cliffgraph/MSX-WiMuse/docs/MSX WiMuse partslist.xlsx

WiMuse partslist
No. | 部品名 | 数量 | 購入元 | 備考
1 | ユニバーサル基板 MPC-P60 (MCC-152 代替) | 1 | 電子部品通販 M.A.D. |  | https://la04528673.shop-pro.jp/
2 | ESP32-DevKitC(もしくはESP32-DevKitC-32E) | 1 | 秋月電子 | 通販コード M-11819 | https://akizukidenshi.com/catalog/g/gM-11819/
3 | Sipeed Tang Nano FPGAボード GW1N-1 FPGAチップ | 1 | Seeed |  | https://jp.seeedstudio.com/Sipeed-Tang-Nano-FPGA-board-powered-by-GW1N-1-FPGA-p-4304.html
4 | 74HC32AP | 1 | 秋月電子 | 通販コード I-12877 | https://akizukidenshi.com/catalog/g/gI-12877/
5 | SN74LVC245AN | 3 | マルツ電波 |  | https://www.marutsu.co.jp/pc/i/14242773/
6 | ICソケット 14ピン | 1 |  | 74HC32AP用
7 | ICソケット 20ピン | 3 |  | SN74LVC245AN用
8 | セラミックコンデンサ 104 | 4
9 | ブレッドボード用ＤＣジャック | 1 | 秋月電子 | 通販コード K-05148 | https://akizukidenshi.com/catalog/g/gK-05148/
10 | 電解コンデンサ 16V 47uF | 1 | 秋月電子 | 通販コード P-10270 | https://akizukidenshi.com/catalog/g/gP-10270/
11 | ピンへッダ２ピン 2.54mmピッチ | 2 | 秋月電子 | 通販コード C-08593 | https://akizukidenshi.com/catalog/g/gC-08593/
12 | ジャンパー用 2.54mmピッチ | 1
13 | ACアダプター センタープラス 5Vで1A以上のもの | 1
14 | 分割ロングピンソケット1x40 | 3 | 秋月電子 | ESP32,TangNano,有機EL用
15 | 0.96インチ有機ELディスプレイ | 1 | 秋月電子 | 通販コード P-12031 | https://akizukidenshi.com/catalog/g/gP-12031/
16 | 抵抗 10kΩ | 2
 | ※16,17は実装しなくても実用上問題なし。
