cliffgraph/MSX-WiMuse/docs/MSX WiMuse schematic.pdf.pdf

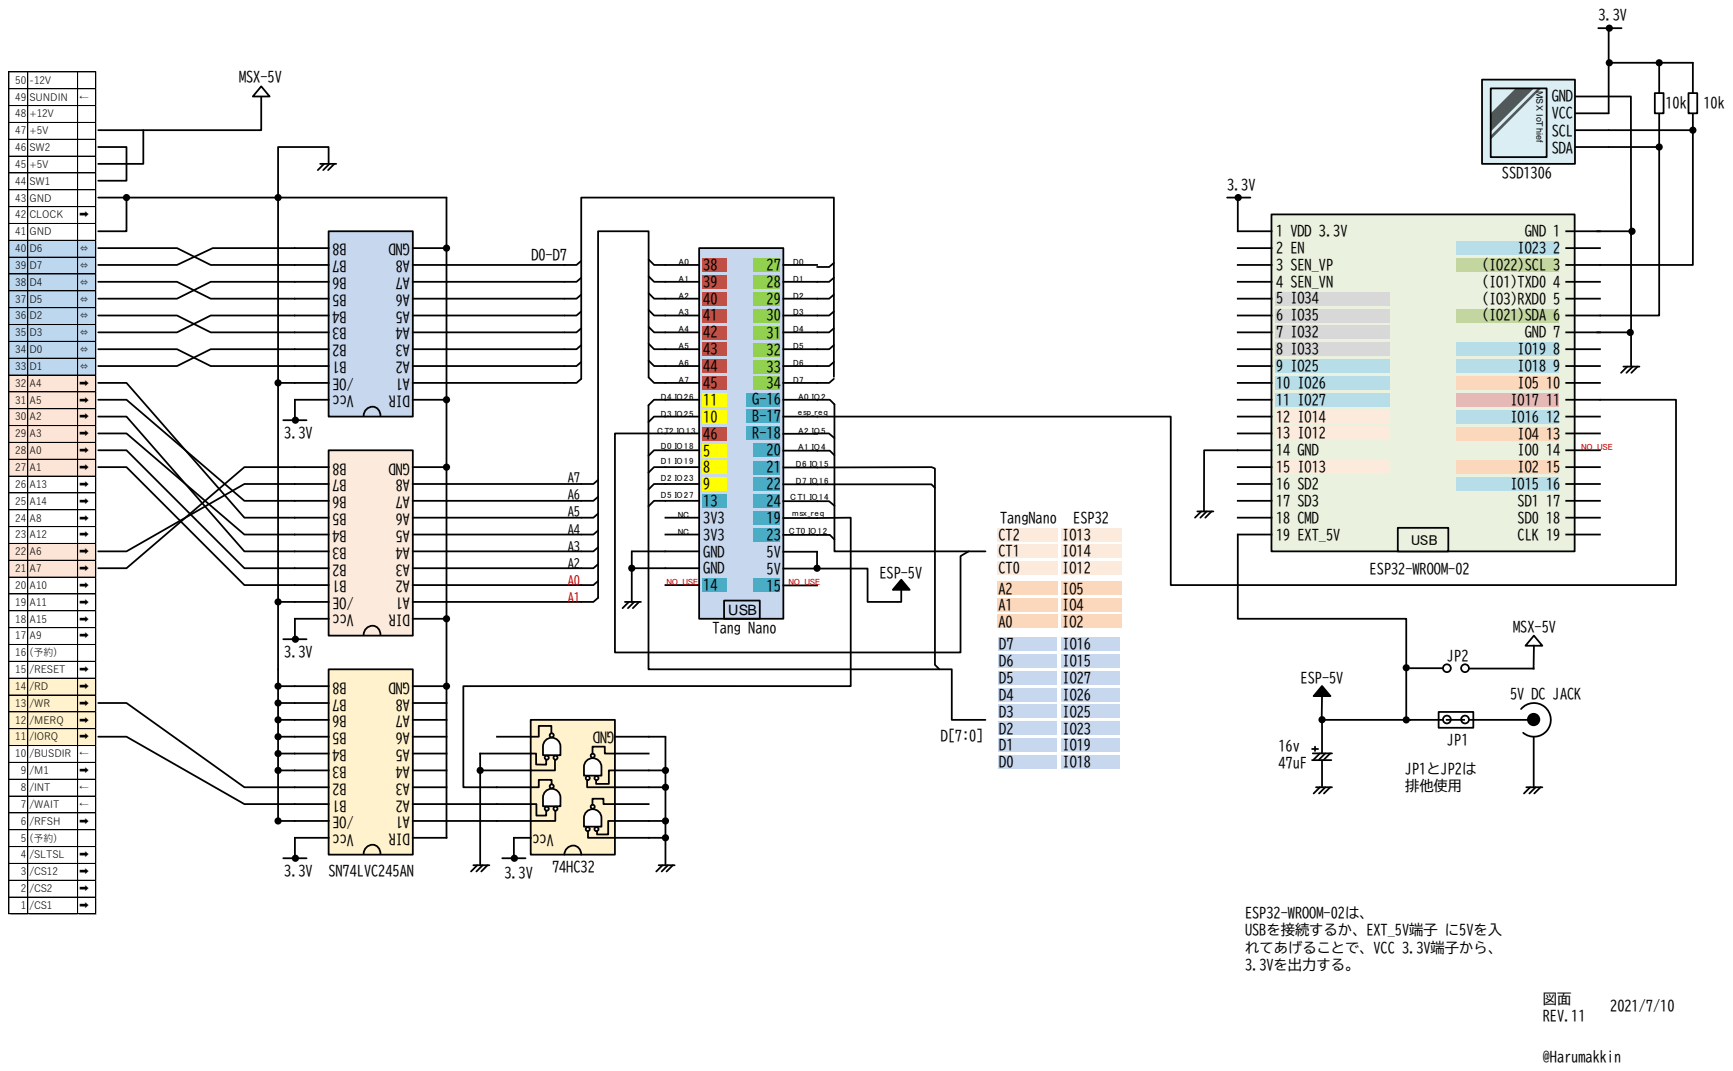
[picture p4: page 1]

50 | -12V
49 | SUNDIN | ←
48 | +12V
47 | +5V
46 | SW2
45 | +5V
44 | SW1
43 | GND
42 | CLOCK | ➡
41 | GND
40 | D6 | ⇔
39 | D7 | ⇔

38 | D4 | ⇔
37 | D5 | ⇔
36 | D2 | ⇔
35 | D3 | ⇔
34 | D0 | ⇔
33 | D1 | ⇔
32 | A4 | ➡
31 | A5 | ➡
30 | A2 | ➡
29 | A3 | ➡
28 | A0 | ➡
27 | A1 | ➡
26 | A13 | ➡
25 | A14 | ➡
24 | A8 | ➡
23 | A12 | ➡
22 | A6 | ➡
21 | A7 | ➡

20 | A10 | ➡
19 | A11 | ➡
18 | A15 | ➡
17 | A9 | ➡
16 | (予約)
15 | /RESET | ➡
14 | /RD | ➡
13 | /WR | ➡
12 | /MERQ | ➡
11 | /IORQ | ➡
10 | /BUSDIR | ←

9 | /M1 | ➡
8 | /INT | ←
7 | /WAIT | ←
6 | /RFSH | ➡
5 | (予約) 4 /SLTSL

3 | /CS12 | ➡
2 | /CS2 | ➡
1 | /CS1 | ➡
